kadiraktass/Smove/README.md

# Solutions for Smove challenges 

In this repo, you can find my solutions for firmware and hardware challenges of [Smove challenges](https://github.com/itatsmove/smovechallenge).
