kadiraktass/Smove/hardware/uno_sensor_shield/uno_sensor_shield_sch.pdf

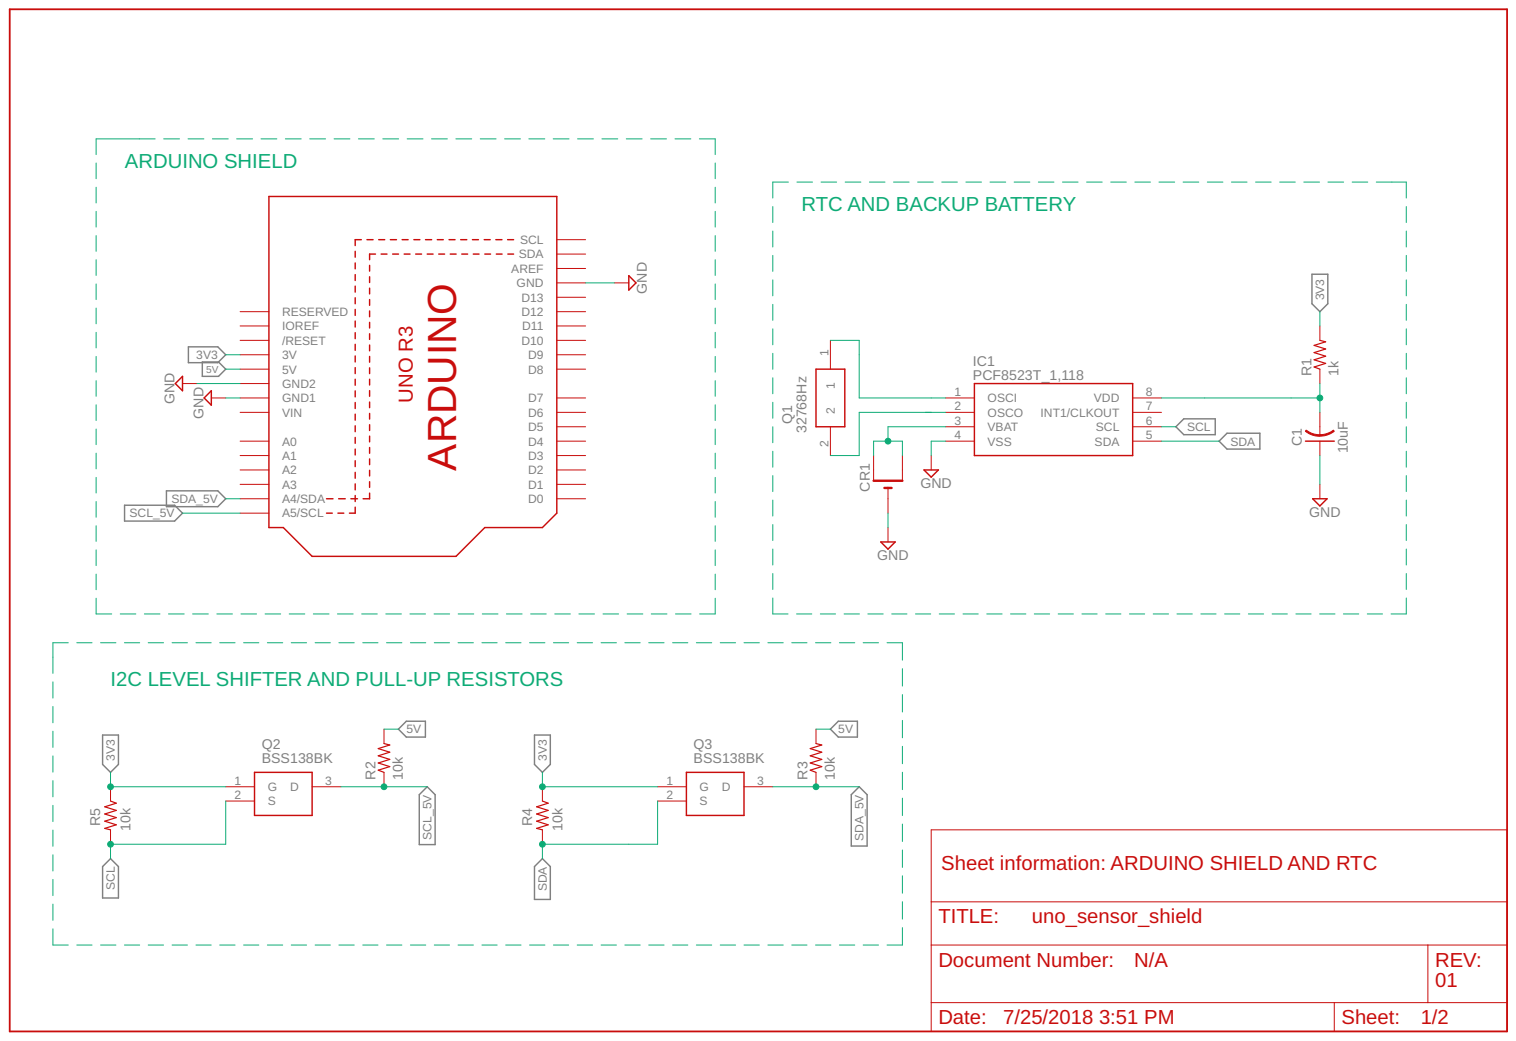
[picture p1: page 1]

RTC AND BACKUP BATTERY

I2C LEVEL SHIFTER AND PULL-UP RESISTORS

Sheet information: ARDUINO SHIELD AND RTC

Document Number: N/A | REV: 01

Date: 7/25/2018 3:51 PM | Sheet: 1/2

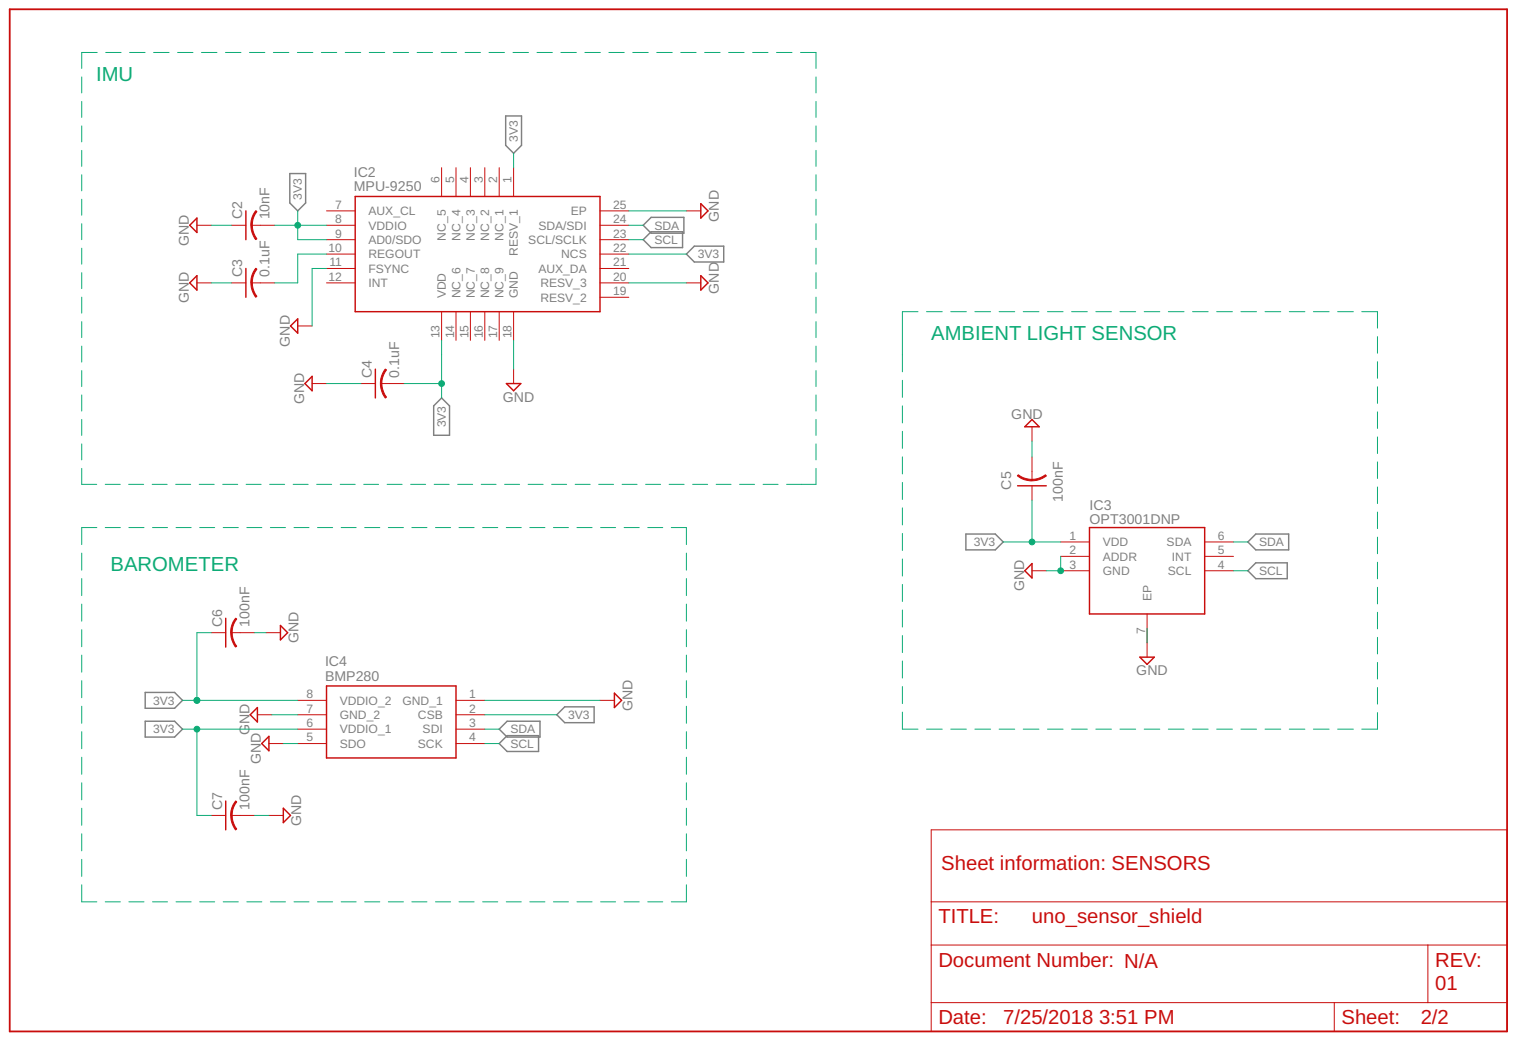
[picture p2: page 2]
