kadiraktass/Smove/hardware/uno_sensor_shield/uno_sensor_shield_layout.pdf

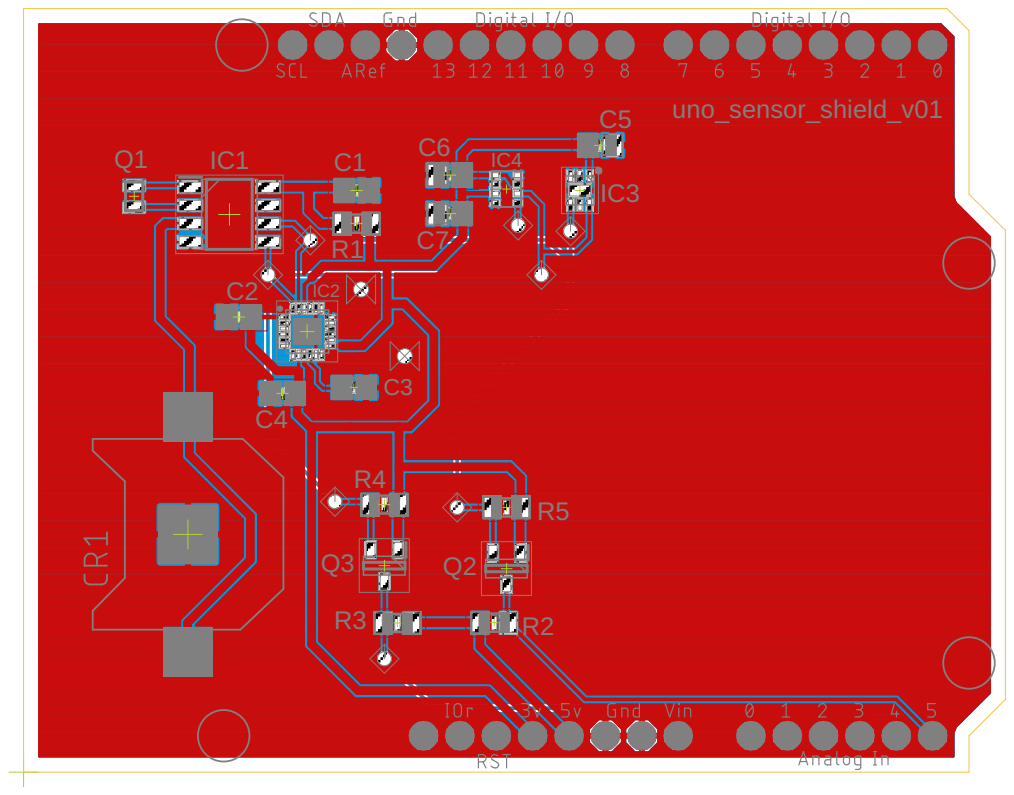
[picture p3: page 1]
