kadiraktass/Smove/hardware/uno_sensor_shield/uno_sensor_shield.brd

## EAGLE design hardware/uno_sensor_shield/uno_sensor_shield.brd (2018-07-25)

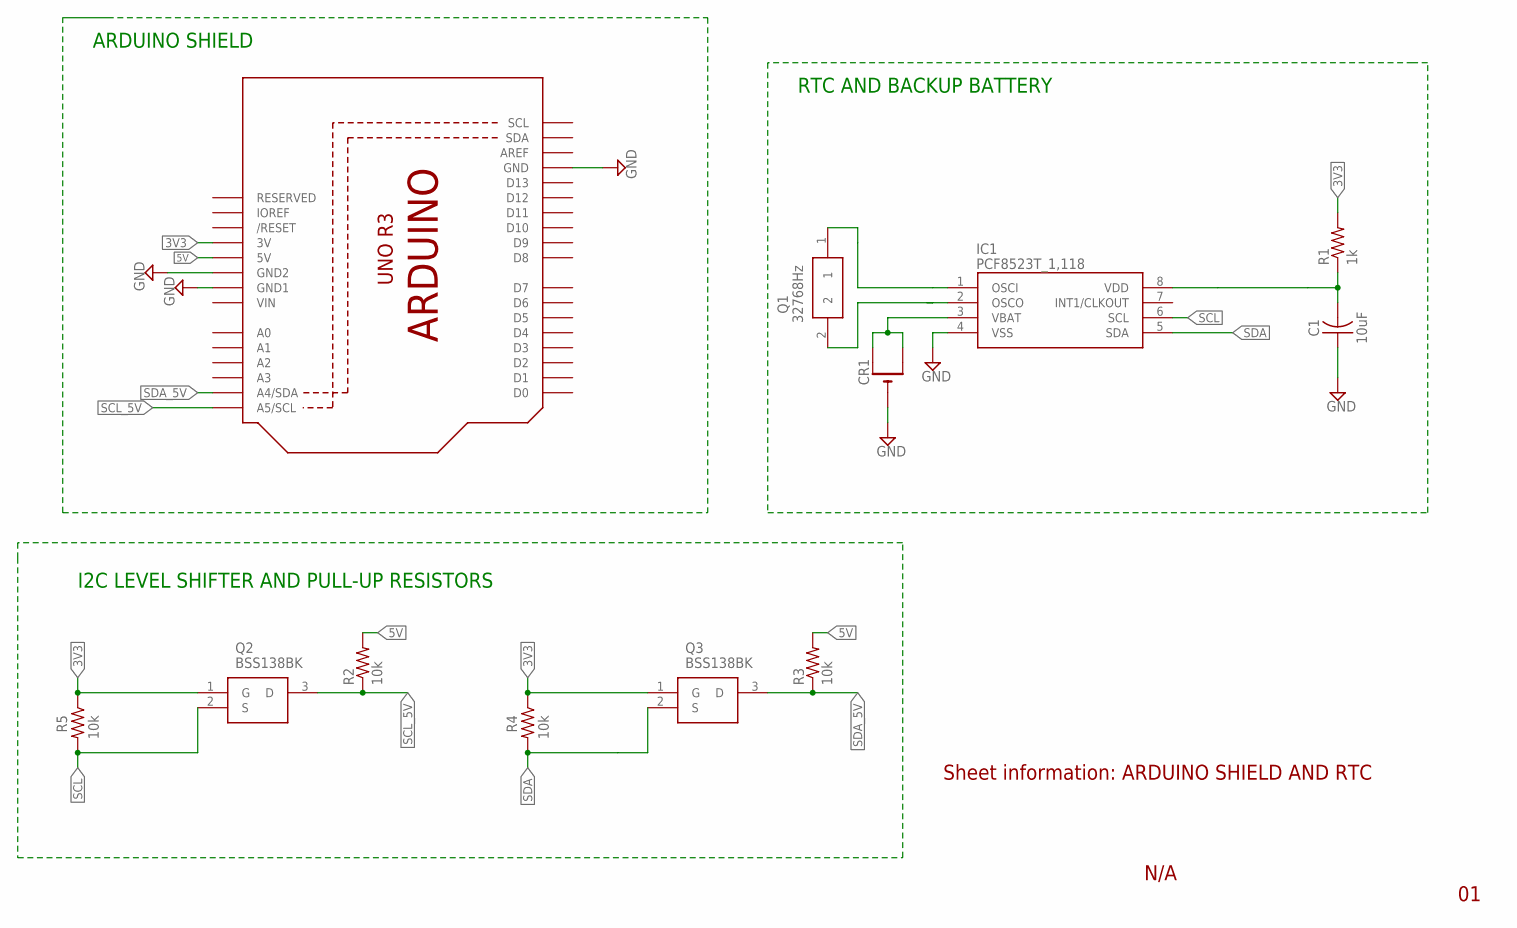
[picture p4: schematic uno_sensor_shield.sch, sheet 1]

Parts:
C1: 10uF; C0805
CR1: CR1220SMT; CR1220-SMD
IC1: PCF8523T_1,118; SOIC127P600X175-8N
Q1: 32768Hz; Q0032768JTX21012520T1LF
Q2, Q3: BSS138BK; SOT95P230X110-3N
R1: 1k; R0805
R2, R3, R4, R5: 10k; R0805
U1: ARDUINOR3-DIMENSION; ARDUINOR3

Connections:
3V3: Q2.1 (G), Q3.1 (G), R1.2, R4.1, R5.1, U1.3V; also elsewhere on the board
5V: R2.2, R3.2, U1.5V
GND: C1.1, CR1.-, IC1.4 (VSS), U1.GND, U1.GND1, U1.GND2; also elsewhere on the board
unnamed: IC1.2 (OSCO), Q1.2
unnamed: C1.2, IC1.8 (VDD), R1.1
unnamed: IC1.1 (OSCI), Q1.1
SCL: IC1.6 (SCL), Q2.2 (S), R5.2; also elsewhere on the board
SCL_5V: Q2.3 (D), R2.1, U1.A5 (A5/SCL)
SDA: IC1.5 (SDA), Q3.2 (S), R4.2; also elsewhere on the board
SDA_5V: Q3.3 (D), R3.1, U1.A4 (A4/SDA)
VBAT: CR1.+$1 (+), CR1.+$2 (+1), IC1.3 (VBAT)
VIN: U1.VIN

Notes on the sheet:
I2C LEVEL SHIFTER AND PULL-UP RESISTORS
N/A
Sheet information: ARDUINO SHIELD AND RTC
ARDUINO SHIELD
RTC AND BACKUP BATTERY

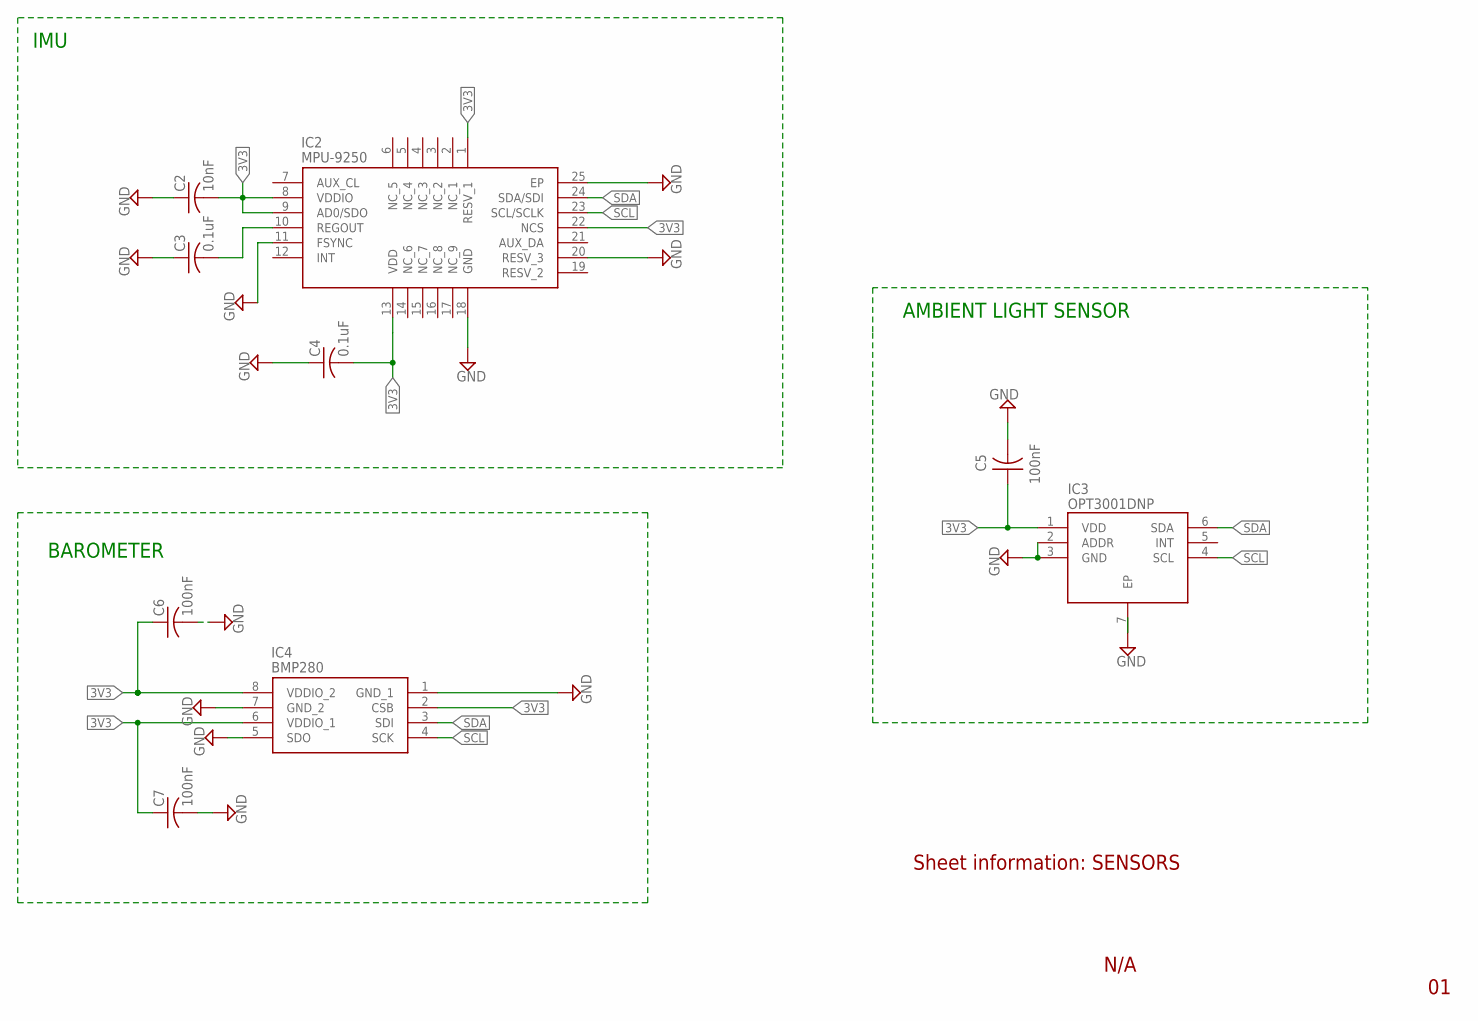
[picture p5: schematic uno_sensor_shield.sch, sheet 2]

Parts:
C2: 10nF; C0805
C3, C4: 0.1uF; C0805
C5, C6, C7: 100nF; C0805
IC2: MPU-9250; QFN40P300X300X105-25N
IC3: OPT3001DNP; SON65P200X200X65-7N
IC4: BMP280; 8-PIN-METAL-LID-LGA

Connections:
3V3: C2.2, C4.2, C5.1, C6.1, C7.1, IC2.1 (RESV_1), IC2.8 (VDDIO), IC2.9 (AD0/SDO), IC2.13 (VDD), IC2.22 (NCS), IC3.1 (VDD), IC4.2 (CSB), IC4.6 (VDDIO_1), IC4.8 (VDDIO_2); also elsewhere on the board
GND: C2.1, C3.1, C4.1, C5.2, C6.2, C7.2, IC2.11 (FSYNC), IC2.18 (GND), IC2.20 (RESV_3), IC2.25 (EP), IC3.2 (ADDR), IC3.3 (GND), IC3.7 (EP), IC4.1 (GND_1), IC4.5 (SDO), IC4.7 (GND_2); also elsewhere on the board
unnamed: C3.2, IC2.10 (REGOUT)
SCL: IC2.23 (SCL/SCLK), IC3.4 (SCL), IC4.4 (SCK); also elsewhere on the board
SDA: IC2.24 (SDA/SDI), IC3.6 (SDA), IC4.3 (SDI); also elsewhere on the board

Notes on the sheet:
Sheet information: SENSORS
N/A
IMU
BAROMETER
AMBIENT LIGHT SENSOR

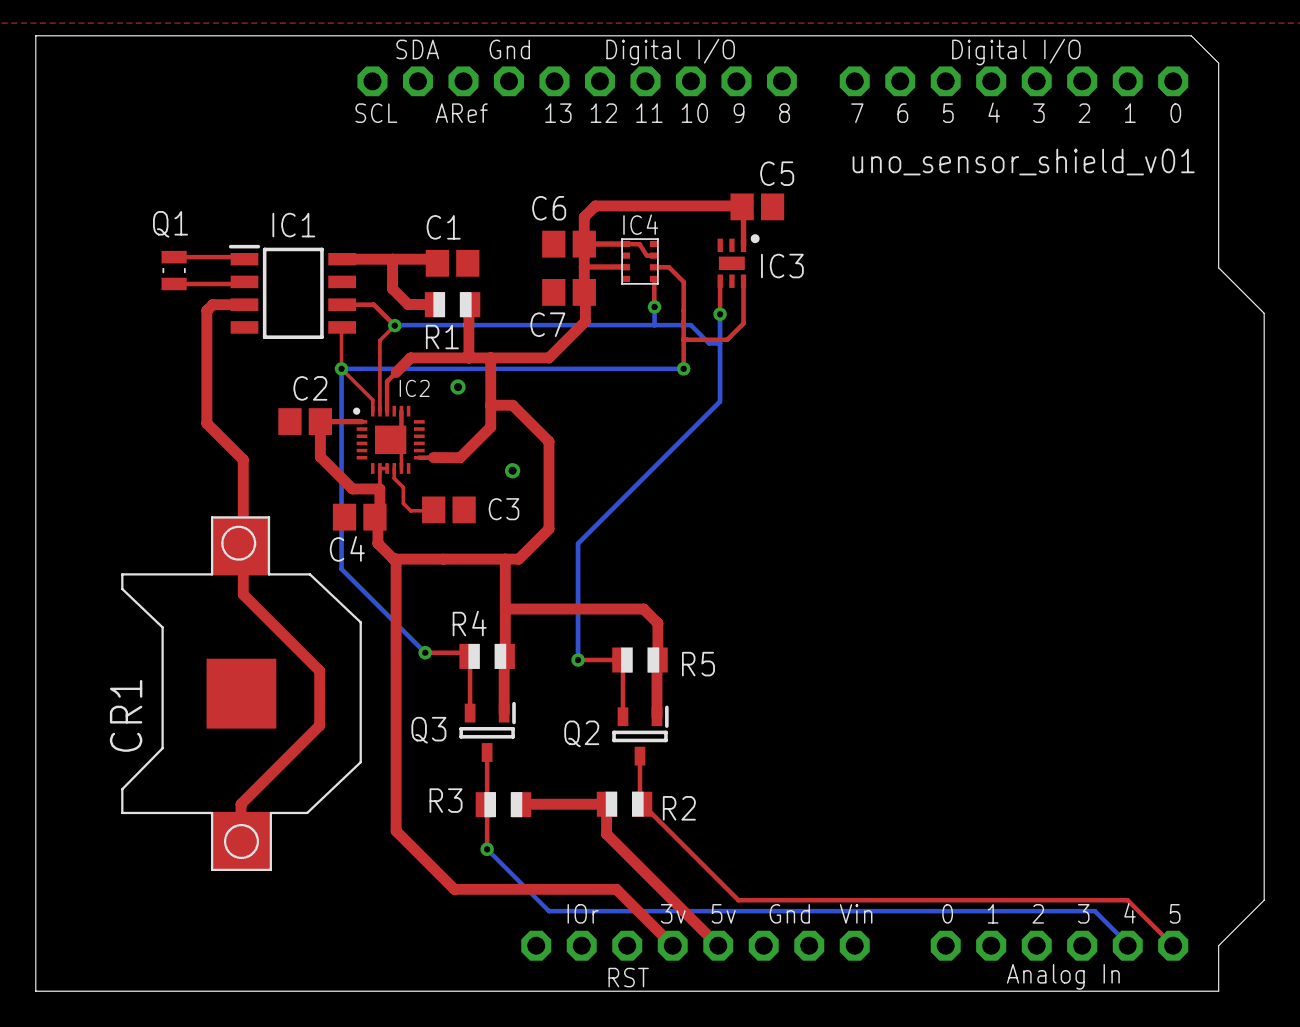
[picture p6: board uno_sensor_shield.brd from above]

Board: 2 copper layers, 68.6 x 53.3 mm, 21 parts (0 on the bottom side), 12 nets.
