kadiraktass/Smove/(commit log)

2018-07-25 solutions are updated
    [uno_sensor_shield.brd, uno_sensor_shield.sch, uno_sensor_shield_bom.csv]
2018-07-25 solutions are added
    [uno_sensor_shield.brd, uno_sensor_shield.sch, uno_sensor_shield_bom.csv]
